gfoot/simplevga6502/hardware/README.md

# Simple VGA 6502 hardware design

This folder contains the schematic for the Simple VGA circuit, which is a
fairly minimalist way to get VGA output from a 6502 breadboard computer like
Ben Eater's.

It's specifically designed to extend Ben Eater's 6502 breadboard computer, and
the 6502, RAM, ROM, 6522, and LCD are not shown here.

If you're working to a different 6502-based (or other CPU) design then you'll
probably need to change some of the glue logic, and definitely the code.

The hardware here won't do anything useful without the software - part of the
simplicity trade-off is that the software is more complex and critical.

See https://github.com/gfoot/simplevga6502/tree/main/src for sample source
code.

## Before you start

Before building, disconnect the following pins in the BE6502:

    ROM: pin 22 (nOE)
    6502: pin 37 (PHI2 input)

These will be driven by elements of the new circuit.

## Breadboard layout

I built this on two breadboards, connected to the top of the BE6502.  The two
boards contain (left to right, top to bottom):

* X1, U1, U2, U3, U4, U5, U6
* U7, U8, U9, U10, U11, U12, R1..9

The R1..9 area is also where the final video output comes from.

## Bill of Materials

* X1 - Crystal oscillator - 25.175MHz
* U1 - 74ACT163 - 4-bit counter
* U2,U3,U4 - 74HC590 - 8-bit counters, tristate with registers
* U5 - 71256SA15 - video RAM, 32k, <80ns access time
* U6 - 74HCT273 - octal synchronous D-flipflop
* U7 - 74HCT74 - dual D-flipflops
* U8 - 74HCT04 - hex inverters
* U9 - 74AHCT00 - quad 2-input NAND
* U10,U11,U12 - 74AHCT245 - octal bus transceivers
* R1,R2,R3 - 470R
* R4,R5,R6 - 680R
* R7,R8,R9 - 220R

## Testing and diagnosis

Just some hints here for now...

### General starting point

If things don't work, the first thing to do is check the 6502 side of things is
working properly.  You should be able to run normal BE6502 programs without
changes, and see output on the LCD.  If this doesn't work then nothing else
will.

### No sync / picture

If the 6502 is working properly but the monitor isn't reporting a valid sync
signal, then you need to determine why.

Usually I probe various signals with a frequency meter, starting with the
25.175MHz clock, then the HS signal which should show about 31.5kHz.  I can't
usually probe VS due to it having a very short, infrequent pulse, but it ought
to be 70Hz.

If those frequencies are good, then the monitor ought to be syncing correctly.

If the frequencies are wrong, you need to find out why.  The sync signal comes
from values stored in video RAM.  You need to ensure that the video RAM
counters are incrementing at the right rates, to the right values, before the
sync signals should be output, and that the sync signals are coming out at
those points.  A logic analyzer is a really good way to check this.

You could also try to probe the RAM contents somehow, to check whether its
contents got corrupted, or just weren't written properly by the CPU.

### Corruption in the picture

This isn't a good sign but could indicate minor issues with the write signal
timing.  Having a valid sync signal at all generally means things are working
pretty well in that respect, though.  Sometimes I see this sort of corruption
after a non-clean reset, and pressing the reset button makes it work well the
next time.

Another cause is poor power supply - as with all large breadboard projects,
daisy-chaining power from board to board can lead to bad brownouts.  I
recommend using a star topology for power distribution, with a direct line from
the power supply to each breadboard rail, and a bulk capacitor (e.g. 330uF)
near the power connection on each rail to compensate for inductance in the
power wiring.

You should also add 100nF capacitors liberally throughout the circuit as usual.
