gfoot/simplevga6502/hardware/simplevga6502.sch

## KiCad design hardware/simplevga6502.sch (2021-01-06)

Schematic: simplevga6502.sch

Parts:
R1, R2, R3: 470
R4, R5, R6: 680
R7, R8, R9: 220
U1: 74ACT163
U2, U3, U4: 74HC590
U5: 71256SA15; DIP-28_W15.24mm
U6: 74HCT273
U7: 74HCT74
U8: 74HCT04
U9: 74AHCT00
U10, U11, U12: 74AHCT245
X1: 25.175MHz; Oscillator_DIP-8

Notes on the sheet:
Simple VGA extension to BE6502
29/12/2020
Simple 160x100 VGA extension to BE6502. The output mode is based on 640x400. Video memory overlays ROM and is write-only. Chips specified here are the ones I've used, but aren't necessarily required, e.g. substituting HCT for AHCT might be fine in some or all cases. Some VCC and GND connections hav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
This fits on two breadboards added to a standard BE6502 build: Board 1: X1, U1, U2, U3, U4, U5, U6 Board 2: U7, U8, U9, U10, U11, U12, R1..9 Before starting, remove the existing clock input from the BE6502 and disconnect the ROM's OE signal, which BE6502 has permanently wired low. These will will b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
https://github.com/gfoot/simplevga6502
