gfoot/simplevga6502/hardware/CHANGELOG.md

# SimpleVGA 6502 Schematic Changelog

## Rev 2 - 06/01/2021

* Drive PHI2 and VRAMWE D-flipflops from ~CLK2 rather than ~CLK1 - better stability
* Removed some NAND gate elements duplicated from BE6502 from the schematic, to be less intrusive

## Rev 1 - 25/12/2020

* First release
