gfoot/simplevga6502/(commit log)

2020-12-29 Added schematics and build notes, updated README
2020-12-30 Invert the reset signal due to changes in the circuit
2021-01-06 Updated schematic - removed some elements of the BE6502 to keep things more separate; changed clocking of D flip-flops for better stability
    [simplevga6502.sch]
2021-03-28 Updated schematics for higher resolutions
    [simplevga_320_100.sch, simplevga_320_200.sch, simplevga_320_400.sch, simplevga_320_480.sch]
